CH4-Inker/inker/firmware/inker/inker.ino

/*
 * Inker v2 — integrated build: A2DP audio sink + BLE control + 2 servos +
 * animated OLED face (bitmap frame animations).
 * ------------------------------------------------------------
 * Merges:
 *   - esp32/a2dp_dac              (A2DP sink, superseded here by the I2S/BLE
 *                                   version from your friend's "Inker" build)
 *   - esp32/doble_servo_copy_...  (servo sweep — trimmed from 3 servos to 2,
 *                                   moved off GPIO21 which the OLED needs)
 *   - Downloads/inker.ino         (bitmap-frame face animation: forward /
 *                                   backward / play / pause / idle-blink /
 *                                   playing-loop — replaces the old placeholder
 *                                   rectangle eyes)
 *
 * HARDWARE: ORIGINAL ESP32 (WROOM / WROVER) only — needs Classic Bluetooth
 *           for A2DP, running alongside BLE in dual mode.
 *
 * PIN MAP
 *   Internal DAC audio out (fixed pins, not configurable):
 *     GPIO25 = DAC channel 1 (right), GPIO26 = DAC channel 2 (left)
 *     -> coupling cap -> amp (e.g. LM386) -> speaker
 *   Servo 1 = GPIO13, Servo 2 = GPIO4
 *   OLED (SSD1306 128x64, I2C, addr 0x3C): SDA = GPIO21, SCL = GPIO22 (ESP32 defaults)
 *
 * NOTE: internal DAC is 8-bit (A2DP audio is 16-bit), so a faint hiss is a
 * hardware limit, not a bug. For clean audio, switch to an external I2S DAC.
 *
 * LIBRARIES (Arduino Library Manager):
 *   "ESP32-A2DP" by pschatzmann, "ESP32Servo", "Adafruit GFX Library",
 *   "Adafruit SSD1306". BLE (BLEDevice/BLEServer/BLEUtils) ships with the
 *   ESP32 Arduino core.
 *
 * BOARD SETTINGS: use a partition scheme with more app space (e.g. "Huge APP
 * (3MB No OTA/1MB SPIFFS)") — BT Classic + BLE dual mode plus A2DP, Servo,
 * and Adafruit GFX together need more flash than the default scheme.
 *
 * BLE control UUIDs MUST match ESP32Link.swift on the watch — these were
 * regenerated for v2 because the old ones (0000A100.../0000A101...) collided
 * with another ESP32 nearby. Update the watch-side app to match.
 */

#include "BluetoothA2DPSink.h"
#include <BLEDevice.h>
#include <BLEServer.h>
#include <BLEUtils.h>
#include <ESP32Servo.h>
#include <Wire.h>
#include <Adafruit_GFX.h>
#include <Adafruit_SSD1306.h>

const char* DEVICE_NAME = "Inker v2";

// ============================================================
//  Audio (A2DP -> internal DAC, GPIO25/GPIO26 — fixed by hardware)
// ============================================================
BluetoothA2DPSink a2dp_sink;

// The library's default volume curve (A2DPDefaultVolumeControl) only ever
// attenuates — its clipping limit tops out just under 1.0x gain, so it can
// never make quiet audio louder than what the source (the watch) sends. The
// watch's own AVRCP volume reports low, so playback stays quiet no matter
// what. This class uses that same exponential curve but doubles the result;
// update_audio_data() (inherited from A2DPVolumeControl, unchanged) still
// clips each sample to the valid 16-bit range, so loud passages saturate
// cleanly instead of wrapping/overflowing.
constexpr float AUDIO_GAIN = 2.0f;   // software amplification factor

class DoubleGainVolumeControl : public A2DPVolumeControl {
 public:
  void set_volume(uint8_t volume) override {
    constexpr float base = 1.4f;
    constexpr float bits = 12.0f;
    constexpr float zero_ofs = pow(base, -bits);
    constexpr float scale = pow(2.0f, bits);
    float f = (pow(base, volume * bits / 127.0f - bits) - zero_ofs) * scale /
              (1.0f - zero_ofs);
    volumeFactor = (int32_t)(f * AUDIO_GAIN);
  }
};

DoubleGainVolumeControl g_volumeControl;

// ============================================================
//  BLE control channel (watch -> ESP32 command frames)
// ------------------------------------------------------------
//  The watch (BLE central) writes short "$CMD#" frames here when the user
//  controls playback. Runs alongside A2DP in dual mode (BR/EDR + BLE).
//  UUIDs MUST match ESP32Link.swift on the watch.
// ============================================================
#define CTRL_SERVICE_UUID "0000A100-0000-1000-8000-00805F9B34FB"
#define CTRL_CHAR_UUID    "0000A101-0000-1000-8000-00805F9B34FB"

String g_rxBuffer;   // accumulates bytes until a full "$...#" frame arrives

// Playback state: true = song playing, false = paused/idle. Drives which face
// animation renderAmbient() shows; set from the pendingAnim dispatch in loop().
volatile bool isPlaying = false;
volatile int g_bleVolume = 0;   // last volume from "$VOL:xx#" BLE command, 0-100

// Animation requested by a BLE command. Set here (fast), rendered in loop() so
// we never block the BLE stack while audio is streaming.
// 0=none, 1=forward(NEXT), 2=backward(PREV), 3=play(PLAY), 4=pause(PAUSE)
volatile int pendingAnim = 0;

// Act on one parsed command (payload WITHOUT the $ and #). Keep this fast —
// only flag work for loop() to do; never call the blocking play*() helpers here.
void handleCommand(const String& cmd) {
  Serial.printf("[CTRL] command: '%s'\n", cmd.c_str());
  if (cmd == "NEXT")       { triggerServo2Pulse(); pendingAnim = 1; }
  else if (cmd == "PREV")  { triggerServo2Pulse(); pendingAnim = 2; }
  else if (cmd == "PLAY")  { triggerServo2Pulse(); pendingAnim = 3; }
  else if (cmd == "PAUSE") { triggerServo2Pulse(); pendingAnim = 4; }
  else if (cmd.startsWith("VOL:")) {
    int vol = cmd.substring(4).toInt();      // 0..100
    g_bleVolume = vol;
    Serial.printf("[CTRL] volume -> %d%%\n", vol);
  } else {
    Serial.printf("[CTRL] unknown command '%s'\n", cmd.c_str());
  }
}

// Pull every complete "$...#" frame out of the running buffer.
void parseFrames() {
  int start = g_rxBuffer.indexOf('$');
  while (start >= 0) {
    int end = g_rxBuffer.indexOf('#', start + 1);
    if (end < 0) break;                       // partial frame — wait for more
    handleCommand(g_rxBuffer.substring(start + 1, end));
    g_rxBuffer = g_rxBuffer.substring(end + 1);
    start = g_rxBuffer.indexOf('$');
  }
  // Drop any garbage before the first '$' so the buffer can't grow unbounded.
  if (start < 0 && g_rxBuffer.length() > 64) g_rxBuffer = "";
}

class CtrlCharCallbacks : public BLECharacteristicCallbacks {
  void onWrite(BLECharacteristic* c) override {
    String v = c->getValue().c_str();
    Serial.printf("[CTRL] BLE write received (%d bytes): %s\n", v.length(), v.c_str());
    g_rxBuffer += v;
    parseFrames();
  }
};

// Logs when the watch connects / drops the BLE control link, so you can tell
// from the Serial Monitor whether the channel is even up.
class CtrlServerCallbacks : public BLEServerCallbacks {
  void onConnect(BLEServer* s) override {
    Serial.println("[CTRL] >>> watch BLE control link CONNECTED");
  }
  void onDisconnect(BLEServer* s) override {
    Serial.println("[CTRL] <<< watch BLE control link DISCONNECTED — re-advertising");
    BLEDevice::startAdvertising();
  }
};

void startBLEControl() {
  Serial.println("[CTRL] startBLEControl() begin");
  BLEDevice::init(DEVICE_NAME);
  Serial.println("[CTRL] BLEDevice::init done");

  BLEServer* server = BLEDevice::createServer();
  server->setCallbacks(new CtrlServerCallbacks());

  BLEService* service = server->createService(CTRL_SERVICE_UUID);
  BLECharacteristic* ch = service->createCharacteristic(
      CTRL_CHAR_UUID,
      BLECharacteristic::PROPERTY_WRITE | BLECharacteristic::PROPERTY_WRITE_NR);
  ch->setCallbacks(new CtrlCharCallbacks());
  service->start();

  // A 128-bit UUID (16 B) + the device name won't both fit in the 31-byte
  // advertising packet — that overflow silently drops the service UUID, so a
  // filtered scan on the watch never finds us. Put the UUID in the ADV packet
  // and the name in the SCAN-RESPONSE packet instead.
  BLEAdvertising* adv = BLEDevice::getAdvertising();
  BLEAdvertisementData advData;
  advData.setFlags(0x06);                                // general discoverable, BR/EDR not supported (BLE)
  advData.setCompleteServices(BLEUUID(CTRL_SERVICE_UUID));
  adv->setAdvertisementData(advData);

  BLEAdvertisementData scanResp;
  scanResp.setName(DEVICE_NAME);
  adv->setScanResponseData(scanResp);

  BLEDevice::startAdvertising();
  Serial.println("[CTRL] BLE control service advertising (UUID in adv, name in scan-resp).");
}

// --- State we track for the periodic status line ---
volatile uint32_t g_dataPackets = 0;    // incremented every time audio data arrives
volatile uint32_t g_dataBytes   = 0;
int g_connState = -1;                    // last connection state
int g_audioState = -1;                   // last audio state
unsigned long g_lastStatus = 0;

// ============================================================
//  A2DP callbacks
// ============================================================
void connection_state_changed(esp_a2d_connection_state_t state, void* /*ptr*/) {
  g_connState = (int)state;
  Serial.print("[BT] Connection state -> ");
  switch (state) {
    case ESP_A2D_CONNECTION_STATE_DISCONNECTED:
      Serial.println("DISCONNECTED"); break;
    case ESP_A2D_CONNECTION_STATE_CONNECTING:
      Serial.println("CONNECTING..."); break;
    case ESP_A2D_CONNECTION_STATE_CONNECTED:
      Serial.println("CONNECTED  <<< watch is paired!"); break;
    case ESP_A2D_CONNECTION_STATE_DISCONNECTING:
      Serial.println("DISCONNECTING..."); break;
    default:
      Serial.printf("UNKNOWN (%d)\n", (int)state); break;
  }
}

void audio_state_changed(esp_a2d_audio_state_t state, void* /*ptr*/) {
  g_audioState = (int)state;
  Serial.print("[BT] Audio state -> ");
  if (state == ESP_A2D_AUDIO_STATE_STARTED) {
    Serial.println("STARTED (playing)  <<< audio should be coming out now");
  } else {
    Serial.printf("STOPPED/SUSPENDED (%d)\n", (int)state);
  }
}

void data_received() {
  g_dataPackets++;
}

void avrc_metadata(uint8_t id, const uint8_t* text) {
  Serial.printf("[BT] Metadata id=0x%02x : %s\n", id, text);
}

void avrc_volume(int vol) {
  Serial.printf("[BT] AVRCP volume -> %d (0-127)\n", vol);
}

void printStatusHeartbeat(unsigned long now) {
  if (now - g_lastStatus < 2000) return;
  g_lastStatus = now;

  uint32_t packets = g_dataPackets;
  g_dataPackets = 0;

  const char* conn =
    (g_connState == ESP_A2D_CONNECTION_STATE_CONNECTED)     ? "CONNECTED" :
    (g_connState == ESP_A2D_CONNECTION_STATE_CONNECTING)    ? "CONNECTING" :
    (g_connState == ESP_A2D_CONNECTION_STATE_DISCONNECTING) ? "DISCONNECTING" :
    "DISCONNECTED";
  const char* audio =
    (g_audioState == ESP_A2D_AUDIO_STATE_STARTED) ? "PLAYING" : "not playing";

  Serial.printf("[STATUS] conn=%s | audio=%s | data packets last 2s = %lu %s\n",
                conn, audio, (unsigned long)packets,
                packets > 0 ? "(audio is flowing!)" : "(no audio bytes)");
}

// ============================================================
//  Servos — servo1 tracks the BLE "$VOL:xx#" volume (0-100 -> 0-180deg).
//  servo2 pulses 0 -> 45 -> 0 (a "nod") each time NEXT/PREV/PLAY/PAUSE
//  is received.
// ============================================================
static const int SERVO_PIN_1 = 18;
static const int SERVO_PIN_2 = 13;

Servo servo1;
Servo servo2;

int lastVolumeAngle = -1;   // last angle written to servo1, so we only write on change

const int SERVO2_REST_ANGLE  = 0;
const int SERVO2_PULSE_ANGLE = 45;
const unsigned long SERVO2_PULSE_HOLD_MS = 200;  // how long servo2 stays at 45 before returning to 0
bool servo2Pulsing = false;
unsigned long servo2PulseStart = 0;

// Call this from handleCommand() on NEXT/PREV/PLAY/PAUSE to fire a servo2 nod.
void triggerServo2Pulse() {
  servo2Pulsing = true;
  servo2PulseStart = millis();
  servo2.write(SERVO2_PULSE_ANGLE);
}

void updateServos(unsigned long now) {
  // servo1: follow last "$VOL:xx#" BLE volume, 100% -> 180deg
  int volumeAngle = map(g_bleVolume, 0, 100, 0, 180);
  volumeAngle = constrain(volumeAngle, 0, 180);
  if (volumeAngle != lastVolumeAngle) {
    lastVolumeAngle = volumeAngle;
    servo1.write(volumeAngle);
  }

  // servo2: return to rest once the pulse hold time has elapsed
  if (servo2Pulsing && (now - servo2PulseStart >= SERVO2_PULSE_HOLD_MS)) {
    servo2Pulsing = false;
    servo2.write(SERVO2_REST_ANGLE);
  }
}

// ============================================================
//  OLED face — bitmap-frame animations (forward/backward/play/pause + idle
//  eyes / playing loop), ported from Downloads/inker.ino. Driven by isPlaying
//  and pendingAnim (set from BLE NEXT/PREV/PLAY/PAUSE).
// ============================================================
#define SCREEN_WIDTH 128
#define SCREEN_HEIGHT 64
#define OLED_RESET    -1

Adafruit_SSD1306 display(SCREEN_WIDTH, SCREEN_HEIGHT, &Wire, OLED_RESET);

// ============================================================
//  Face animation bitmaps + frame lists (ported from led-test.ino)
// ============================================================
// 'pause1', 128x64px
const unsigned char epd_bitmap_pause1 [] PROGMEM = {
	0x00, 0x00, 0x00, 0x00, 0x00, 0x00, 0x00, 0x00, 0x00, 0x00, 0x00, 0x00, 0x00, 0x00, 0x00, 0x00, 
	0x00, 0x00, 0x00, 0x00, 0x00, 0x00, 0x00, 0x00, 0x00, 0x00, 0x00, 0x00, 0x00, 0x00, 0x00, 0x00, 
	0x00, 0x00, 0x00, 0x00, 0x00, 0x00, 0x00, 0x00, 0x00, 0x00, 0x00, 0x00, 0x00, 0x00, 0x00, 0x00, 
	0x00, 0x00, 0x00, 0x00, 0x00, 0x00, 0x00, 0x00, 0x00, 0x00, 0x00, 0x00, 0x00, 0x00, 0x00, 0x00, 
	0x00, 0x00, 0x00, 0x00, 0x00, 0x00, 0x00, 0x00, 0x00, 0x00, 0x00, 0x00, 0x00, 0x00, 0x00, 0x00, 
	0x00, 0x00, 0x00, 0x00, 0x00, 0x00, 0x00, 0x00, 0x00, 0x00, 0x00, 0x00, 0x00, 0x00, 0x00, 0x00, 
	0x00, 0x00, 0x00, 0x00, 0x00, 0x00, 0x00, 0x00, 0x00, 0x00, 0x00, 0x00, 0x00, 0x00, 0x00, 0x00, 
	0x00, 0x00, 0x00, 0x00, 0x00, 0x00, 0x00, 0x00, 0x00, 0x00, 0x00, 0x00, 0x00, 0x00, 0x00, 0x00, 
	0x00, 0x00, 0x00, 0x00, 0x00, 0x00, 0x00, 0x00, 0x00, 0x00, 0x00, 0x00, 0x00, 0x00, 0x00, 0x00, 
	0x00, 0x00, 0x00, 0x00, 0x00, 0x00, 0x00, 0x00, 0x00, 0x00, 0x00, 0x00, 0x00, 0x00, 0x00, 0x00, 
	0x00, 0x00, 0x00, 0x00, 0x00, 0x00, 0x00, 0x00, 0x00, 0x00, 0x00, 0x00, 0x00, 0x00, 0x00, 0x00, 
	0x00, 0x00, 0x00, 0x00, 0x00, 0x00, 0x00, 0x00, 0x00, 0x00, 0x00, 0x00, 0x00, 0x00, 0x00, 0x00, 
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
	0x00, 0x00, 0x0f, 0xff, 0xff, 0xf0, 0x00, 0x00, 0x00, 0x00, 0x00, 0x00, 0x00, 0x00, 0x00, 0x00,
	0x00, 0x00, 0x0f, 0xff, 0xff, 0xf0, 0x00, 0x00, 0x00, 0x00, 0x01, 0xff, 0xfe, 0x00, 0x00, 0x00,
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
};
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
void loop() {
  unsigned long now = millis();
  updateServos(now);
  printStatusHeartbeat(now);

  if (pendingAnim != 0) {
    int a = pendingAnim;
    pendingAnim = 0;
    // NEXT / PREV: the new song auto-plays, so go straight to the playing face.
    // The watch sends a redundant PLAY right after NEXT/PREV — it becomes a
    // no-op below because isPlaying is already true, so no extra play animation.
    if      (a == 1) { playForward();  isPlaying = true; }
    else if (a == 2) { playBackward(); isPlaying = true; }
    else if (a == 3) { if (!isPlaying) { playPlay();  isPlaying = true;  } }  // animate only if was paused
    else if (a == 4) { if (isPlaying)  { playPause(); isPlaying = false; } }  // animate only if was playing
    lastBlinkTime = millis();   // reset idle timers after the animation
    moveTime = lastBlinkTime;
    return;
  }

  renderAmbient();
}
