CH4-Inker/inker/(commit log)

2026-07-06 Redesign gesture control and add multi-screen UI
    Move Next/Previous/Play-Pause off native Double Tap combos onto a mix of
    Double Tap (next), wrist flick (previous), shake (play/pause), and Digital
    Crown (volume), with hysteresis and calm-motion gating to stop shake from
    also firing flick. Split the single ContentView into paginated Now Playing /
    Controls screens plus Playlist and Gesture guide pages, add cover art,
    marquee/ellipsis long-title handling, and auto-advance when a track ends.
2026-07-08 docs: update TECHREPORT.md with CBL framing, perfboard assembly, power limits, and custom controls
2026-07-08 docs: update accessibility section with Nima's haptic feedback guidance and fix framework naming
2026-07-08 docs: reorder frameworks in tech report addendum with Core Bluetooth as core
2026-07-08 add LED animation
2026-07-09 Integrate BLE control, dual servos, and OLED face animation into firmware
    Merges A2DP audio sink, BLE command channel, 2-servo control, and
    bitmap-frame face animation into a single ESP32 sketch.
2026-07-10 docs: add final product front view and internal wiring images to tech report
